ispaik06/2026_URC_circuit/Power_Distribution_Board/Power_Distribution_Board.kicad_pcb

## KiCad design Power_Distribution_Board/Power_Distribution_Board.kicad_pcb (2025-07-25)

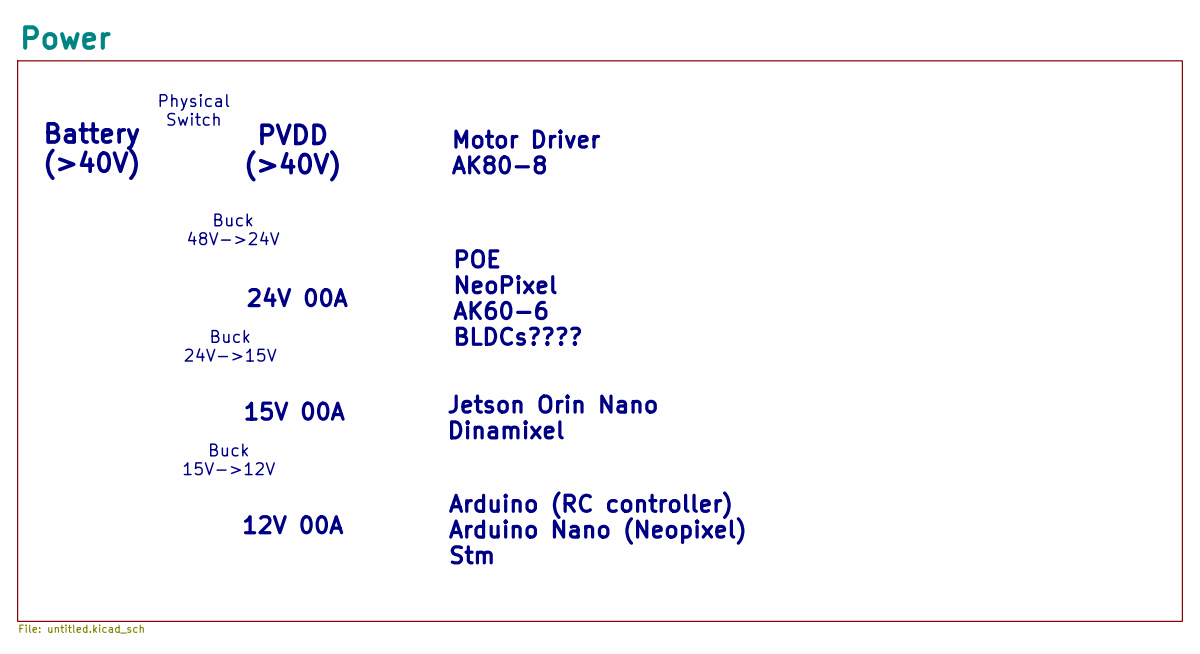
[picture p7: schematic Power_Distribution_Board.kicad_sch]

Notes on the sheet:
Jetson Orin Nano Dinamixel
Motor Driver AK80-8
Arduino (RC controller) Arduino Nano (Neopixel) Stm
Buck 15V->12V
POE NeoPixel AK60-6 BLDCs????
15V 00A
Physical Switch
Buck 48V->24V
24V 00A
12V 00A
Buck 24V->15V
PVDD (>40V)
Battery (>40V)

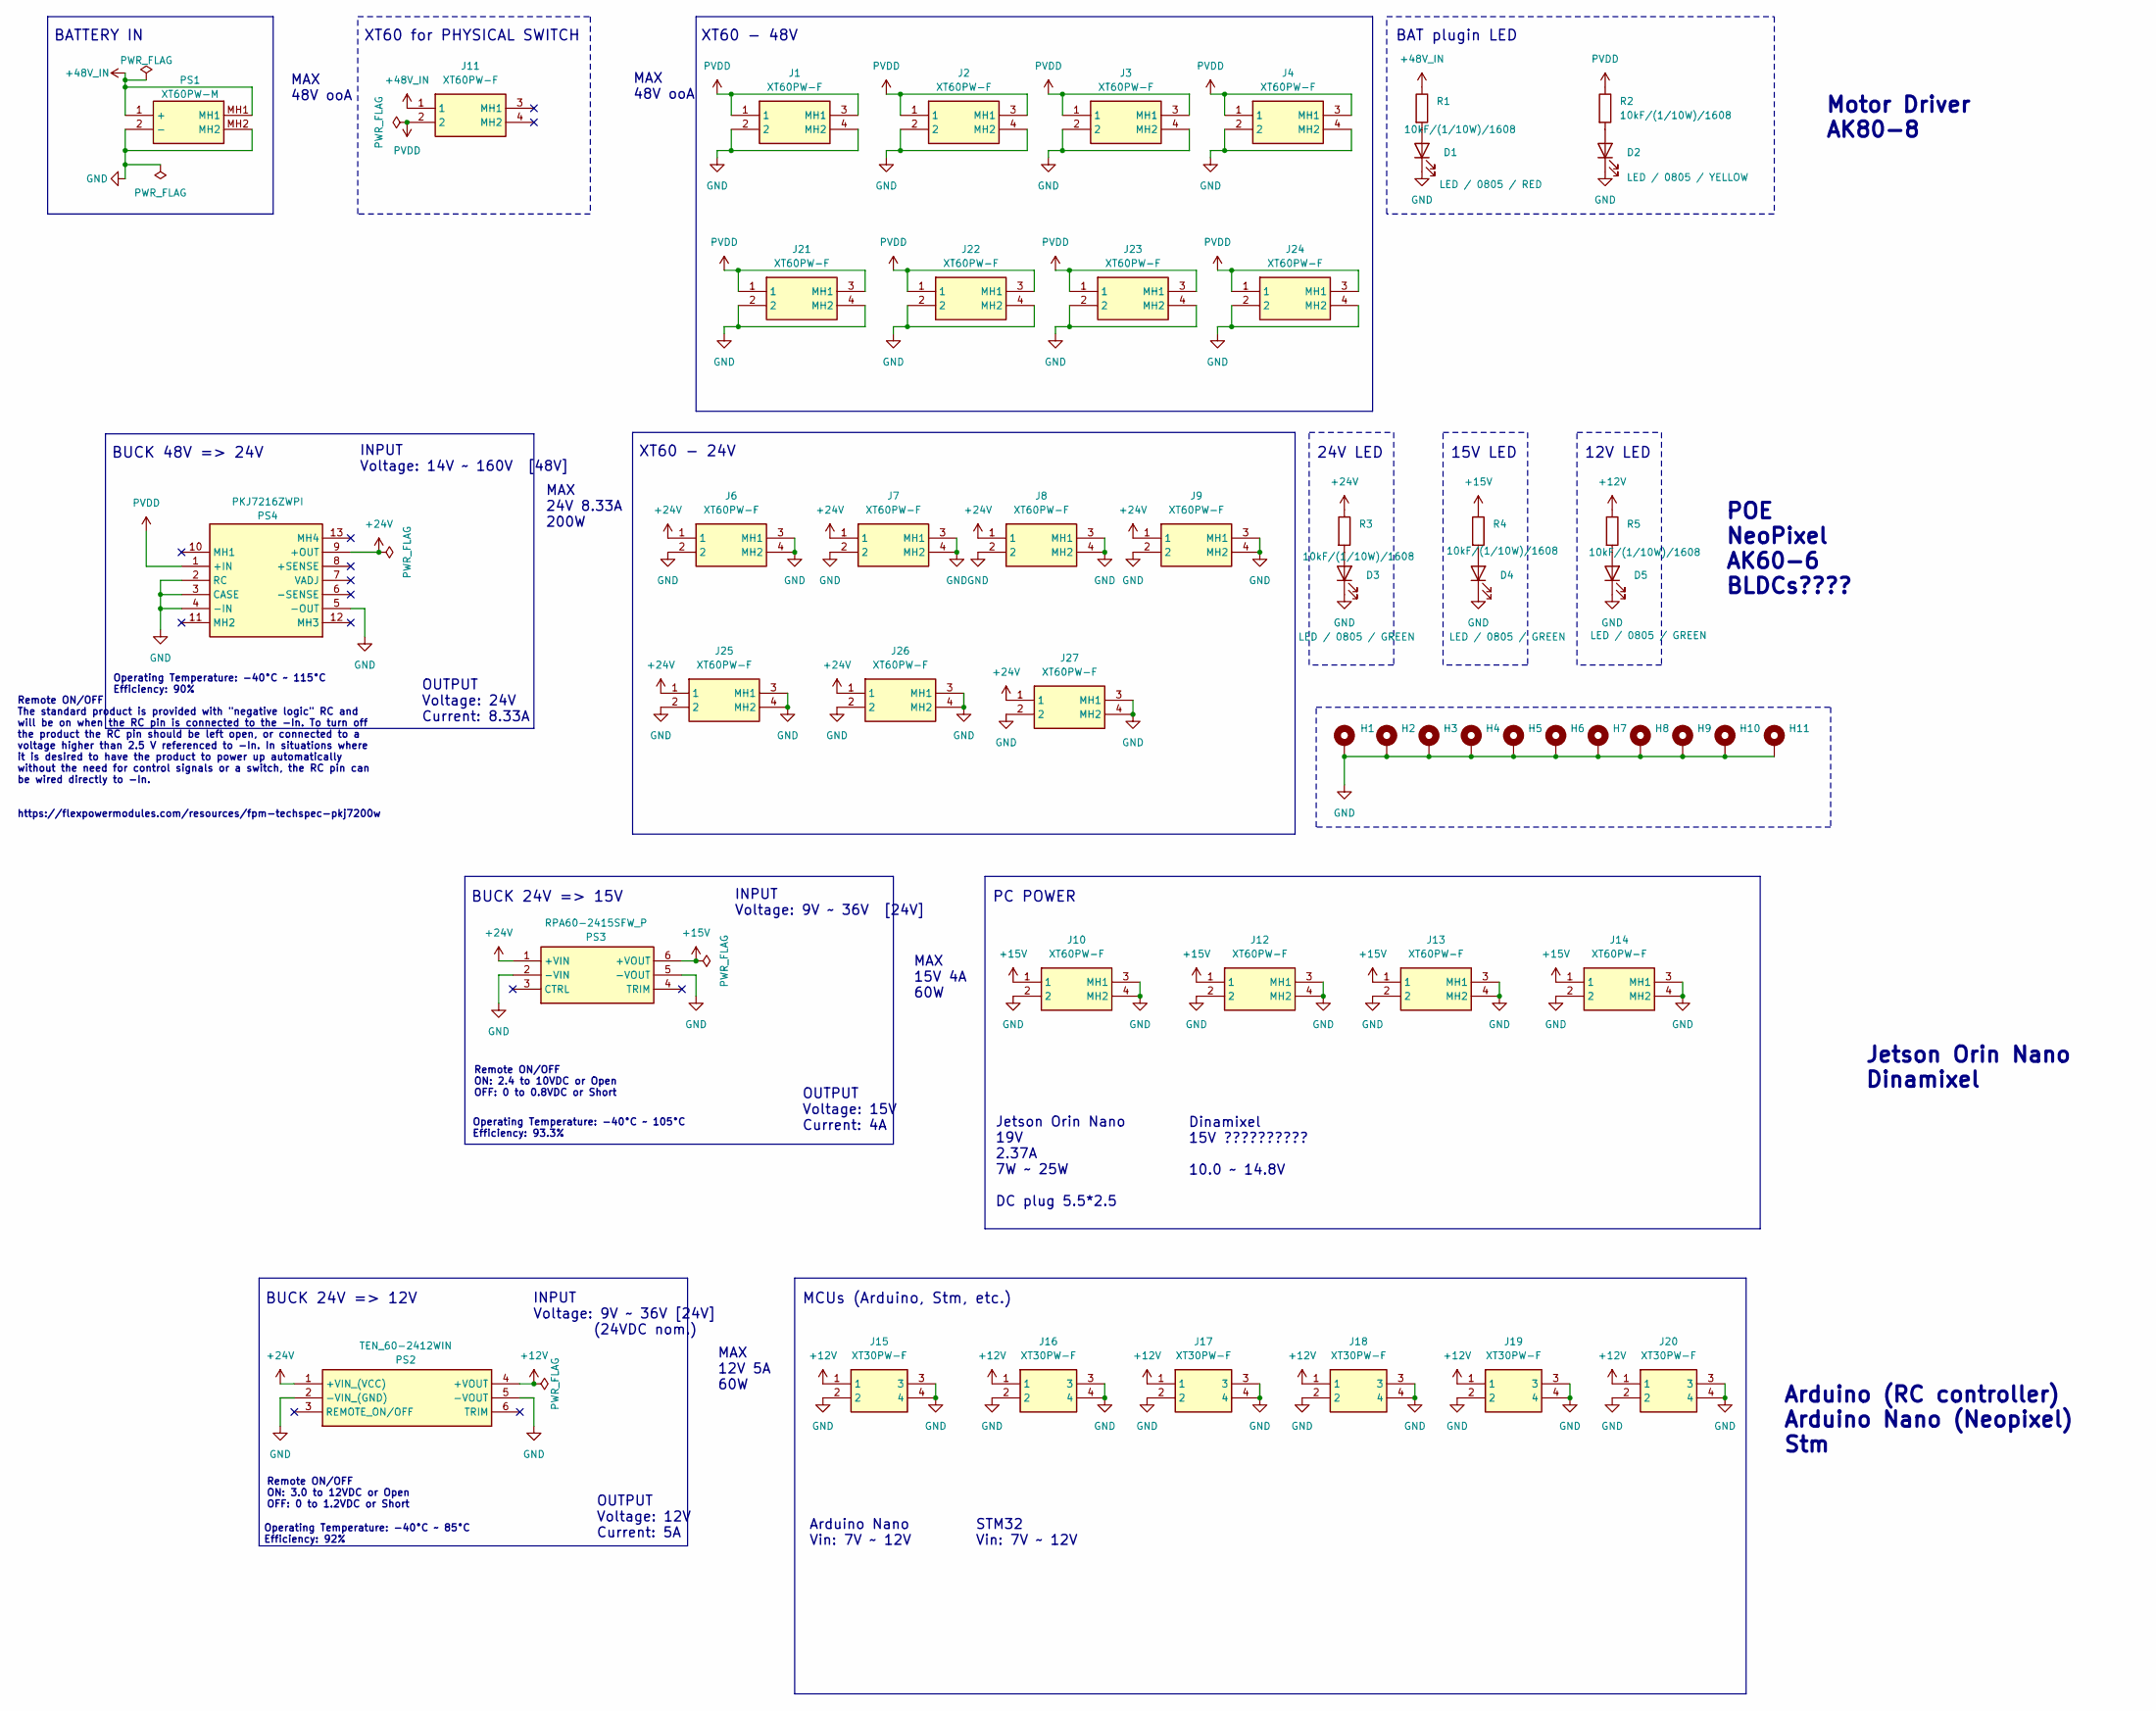
[picture p8: schematic untitled.kicad_sch]

Parts:
D1: LED / 0805 / RED; LED_0805_2012Metric
D2: LED / 0805 / YELLOW; LED_0805_2012Metric
D3, D4, D5: LED / 0805 / GREEN; LED_0805_2012Metric
H1, H2, H3, H4, H5, H6, H7, H8, H9, H10, H11: MountingHole_Pad; MountingHole_3.2mm_M3_Pad
J1, J2, J3, J4, J6, J7, J8, J9, J10, J11, J12, J13, J14, J21, J22, J23, J24, J25, J26, J27: XT60PW-F; XT60PWF; Manufacturer_Part_Number XT60PW-F
J15, J16, J17, J18, J19, J20: XT30PW-F; XT30PWF; Manufacturer_Part_Number XT30PW-F
PS1: XT60PW-M; XT60PWM; Manufacturer_Part_Number XT60PW-M
PS2: TEN_60-2412WIN; TEN602425WIN; Manufacturer_Part_Number TEN 60-2412WIN; Mouser Part Number 495-TEN-60-2412WIN
PS3: RPA60-2415SFW_P; RPA602415SFWP; Manufacturer_Part_Number RPA60-2415SFW/P; Mouser Part Number 919-RPA60-2415SFW/P
PS4: PKJ7216ZWPI; Manufacturer_Part_Number PKJ7216ZWPI
R1, R2, R3, R4, R5: 10kF/(1/10W)/1608; R_0603_1608Metric

Connections:
+12V: J15.1, J16.1, J17.1, J18.1, J19.1, J20.1, PS2.4 (+VOUT), R5.1
+15V: J10.1, J12.1, J13.1, J14.1, PS3.6 (+VOUT), R4.1
+24V: J6.1, J7.1, J8.1, J9.1, J25.1, J26.1, J27.1, PS2.1 (+VIN_(VCC)), PS3.1 (+VIN), PS4.9 (+OUT), R3.1
+48V_IN: J11.1, PS1.1 (+), PS1.MH1, R1.1
GND: D1.1 (K), D2.1 (K), D3.1 (K), D4.1 (K), D5.1 (K), H1.1, H2.1, H3.1, H4.1, H5.1, H6.1, H7.1, H8.1, H9.1, H10.1, H11.1, J1.2, J1.4 (MH2), J2.2, J2.4 (MH2), J3.2, J3.4 (MH2), J4.2, J4.4 (MH2), J6.2, J6.3 (MH1), J6.4 (MH2), J7.2, J7.3 (MH1), J7.4 (MH2), J8.2, J8.3 (MH1), J8.4 (MH2), J9.2, J9.3 (MH1), J9.4 (MH2), J10.2, J10.3 (MH1), J10.4 (MH2), J12.2, J12.3 (MH1), J12.4 (MH2), J13.2, J13.3 (MH1), J13.4 (MH2), J14.2, J14.3 (MH1), J14.4 (MH2), J15.2, J15.3, J15.4, J16.2, J16.3, J16.4, J17.2, J17.3, J17.4, J18.2, J18.3, J18.4, J19.2, J19.3, J19.4, J20.2, J20.3, J20.4, J21.2, J21.4 (MH2), J22.2, J22.4 (MH2), J23.2, J23.4 (MH2), J24.2, J24.4 (MH2), J25.2, J25.3 (MH1), J25.4 (MH2), J26.2, J26.3 (MH1), J26.4 (MH2), J27.2, J27.3 (MH1), J27.4 (MH2), PS1.2 (-), PS1.MH2, PS2.2 (-VIN_(GND)), PS2.5 (-VOUT), PS3.2 (-VIN), PS3.5 (-VOUT), PS4.2 (RC), PS4.3 (CASE), PS4.4 (-IN), PS4.5 (-OUT)
unnamed: D1.2 (A), R1.2
unnamed: D2.2 (A), R2.2
unnamed: D3.2 (A), R3.2
unnamed: D4.2 (A), R4.2
unnamed: D5.2 (A), R5.2
PVDD: J1.1, J1.3 (MH1), J2.1, J2.3 (MH1), J3.1, J3.3 (MH1), J4.1, J4.3 (MH1), J11.2, J21.1, J21.3 (MH1), J22.1, J22.3 (MH1), J23.1, J23.3 (MH1), J24.1, J24.3 (MH1), PS4.1 (+IN), R2.1

Notes on the sheet:
OUTPUT Voltage: 24V Current: 8.33A
MAX 48V ooA
PC POWER
MAX 24V 8.33A 200W
Arduino (RC controller) Arduino Nano (Neopixel) Stm
INPUT Voltage: 14V ~ 160V [48V]
BUCK 48V => 24V
Jetson Orin Nano 19V 2.37A 7W ~ 25W DC plug 5.5*2.5
Jetson Orin Nano Dinamixel
Remote ON/OFF ON: 3.0 to 12VDC or Open OFF: 0 to 1.2VDC or Short
INPUT Voltage: 9V ~ 36V [24V]
Dinamixel 15V ?????????? 10.0 ~ 14.8V
Operating Temperature: -40°C ~ 85°C Efficiency: 92%
Operating Temperature: -40°C ~ 115°C Efficiency: 90%
Operating Temperature: -40°C ~ 105°C Efficiency: 93.3%
MAX 15V 4A 60W
POE NeoPixel AK60-6 BLDCs????
OUTPUT Voltage: 12V Current: 5A
STM32 Vin: 7V ~ 12V
BUCK 24V => 15V
XT60 - 24V
24V LED
XT60 for PHYSICAL SWITCH
Arduino Nano Vin: 7V ~ 12V
Remote ON/OFF ON: 2.4 to 10VDC or Open OFF: 0 to 0.8VDC or Short
Remote ON/OFF The standard product is provided with "negative logic" RC and will be on when the RC pin is connected to the -In. To turn off the product the RC pin should be left open, or connected to a voltage higher than 2.5 V referenced to -In. In situations where it is desired to have the produc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
Motor Driver AK80-8
BAT plugin LED
BATTERY IN
MAX 12V 5A 60W
XT60 - 48V
OUTPUT Voltage: 15V Current: 4A
15V LED
INPUT Voltage: 9V ~ 36V [24V] (24VDC nom.)
12V LED
MCUs (Arduino, Stm, etc.)
BUCK 24V => 12V

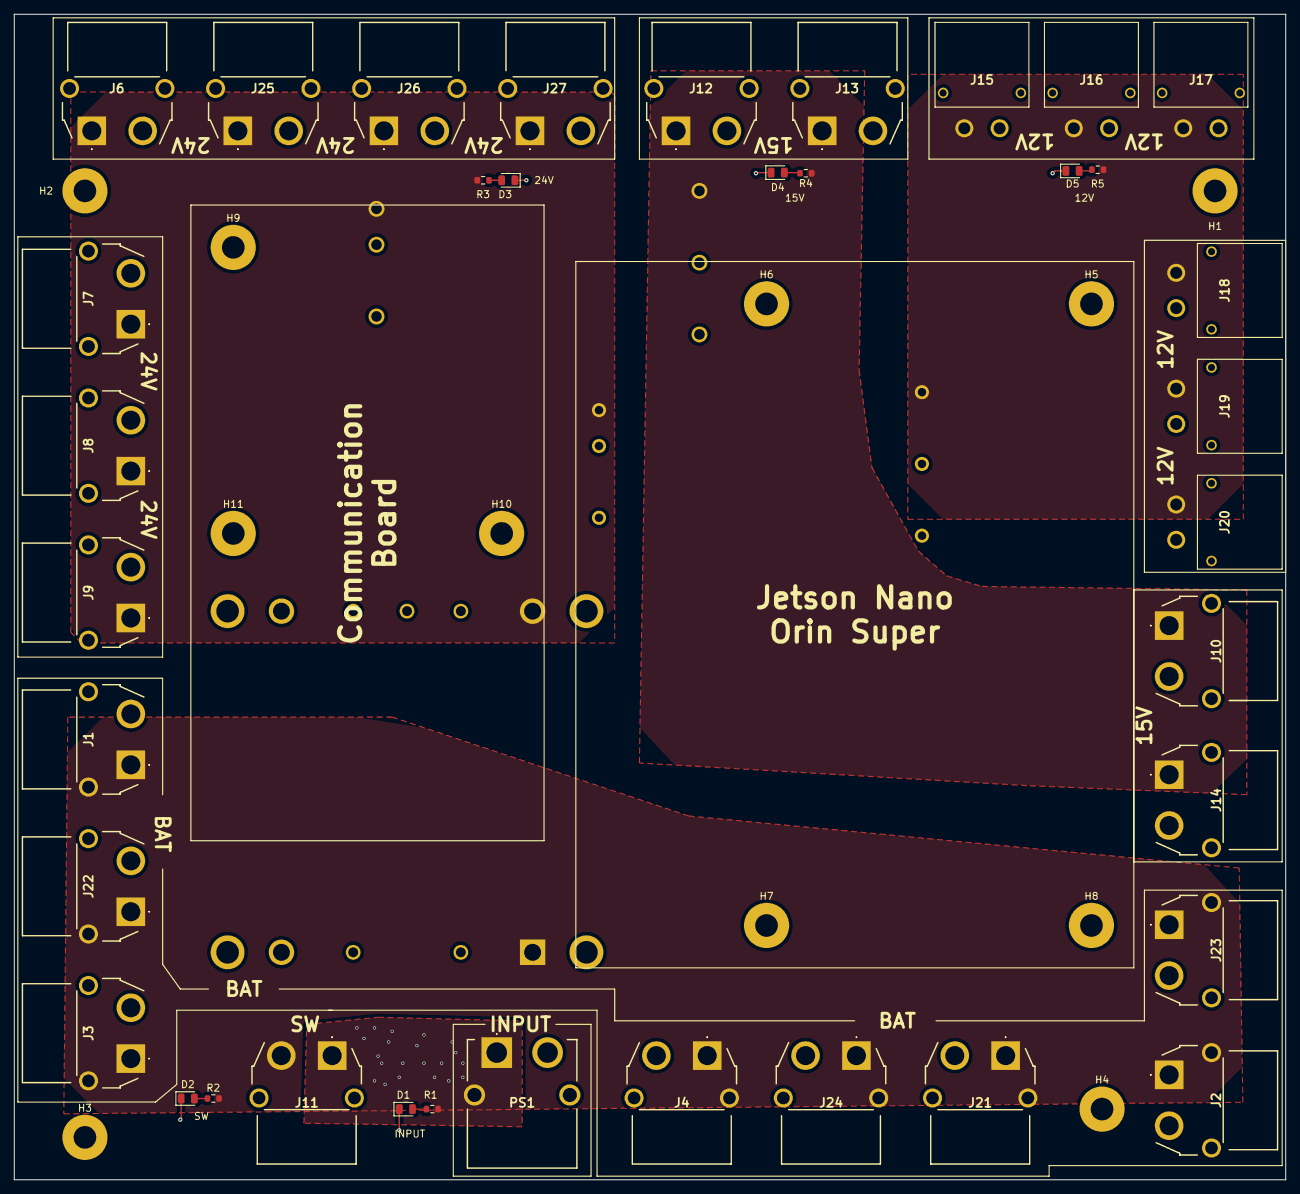
[picture p9: board Power_Distribution_Board.kicad_pcb from above]

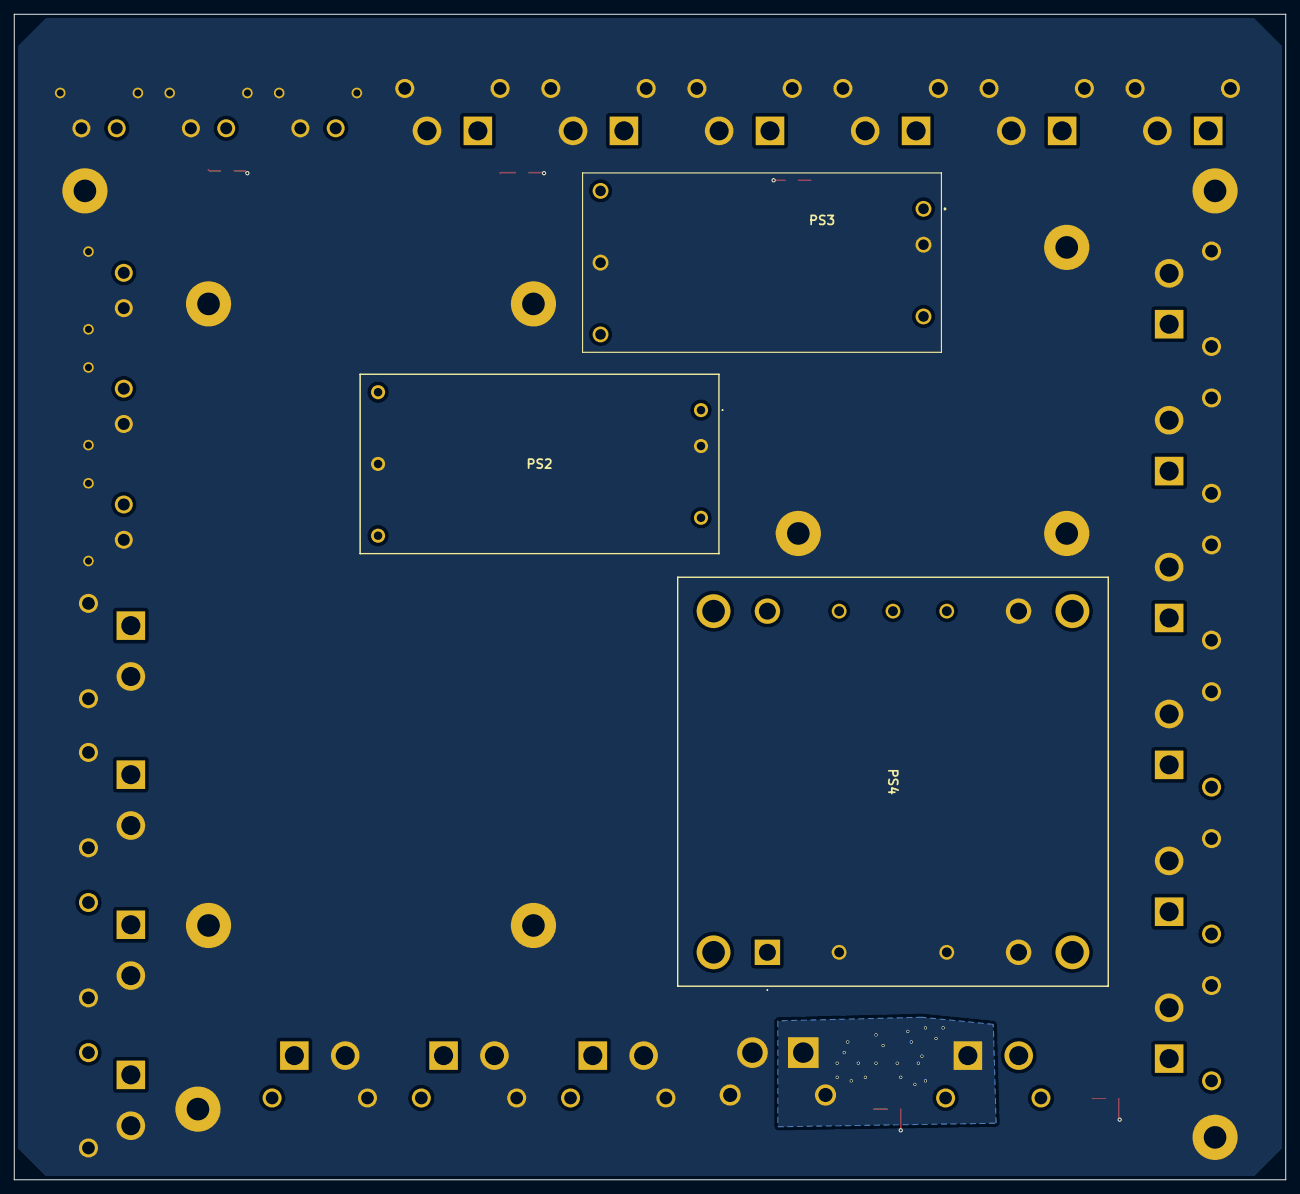
[picture p10: board Power_Distribution_Board.kicad_pcb from below]

Board: 2 copper layers, 180.0 x 165.0 mm, 51 parts (3 on the bottom side), 11 nets.
